atsteen/PrimeBox/README.md

# PrimeBox
Repository for PrimeBox Certified Horticulture Solutions
