atsteen/PrimeBox/Software Projects/PX Series Controller/Software Specifications/PX4/PX4_DisplayMocks.xlsx

Sheet: Sheet2
UC#FR_P_0100
UC#FR_P_0100
 | 1 | 2 | 3 | 4 | 5 | 6 | 7 | 8 | 9 | 10 | 11 | 12 | 13 | 14 | 15 | 16 | 17 | 18 | 19 | 20 | 21
1 | á | 6 | 8 | ° | Û | 5 | 0 | % |  |  |  | ϻ | O | K |  | 0 | 0 | : | 0 | 0 | /n
2 | < |  | E | V | E | N | T |  | T | E | X | T |  | > |  | 0 | 0 | : | 0 | 0 | /n
3 | < |  | E | V | E | N | T |  | T | E | X | T |  | > |  | 0 | 0 | : | 0 | 0 | /n
4 | < |  | E | V | E | N | T |  | T | E | X | T |  | > |  | 0 | 0 | : | 0 | 0 | /n
 | 1 | 2 | 3 | 4 | 5 | 6 | 7 | 8 | 9 | 10 | 11 | 12 | 13 | 14 | 15 | 16 | 17 | 18 | 19 | 20
UC#FR_P_0110
UC#FR_P_0110
 | 1 | 2 | 3 | 4 | 5 | 6 | 7 | 8 | 9 | 10 | 11 | 12 | 13 | 14 | 15 | 16 | 17 | 18 | 19 | 20 | 21
1 |  |  |  |  |  |  |  |  |  |  |  |  |  |  |  |  |  |  |  |  | /n
2 |  |  | ! |  | S | Y | S | T | E | M |  | E | R | R | O | R |  | ! |  |  | /n
3 |  |  | N | O |  | T | I | M | E |  | P | R | O | V | I | D | E | R |  |  | /n
4 |  |  |  |  |  |  |  |  |  |  |  |  |  |  |  |  |  |  |  |  | /n
 | 1 | 2 | 3 | 4 | 5 | 6 | 7 | 8 | 9 | 10 | 11 | 12 | 13 | 14 | 15 | 16 | 17 | 18 | 19 | 20
UC#FR_P_0120
UC#FR_P_0120b |  |  |  |  |  |  |  |  |  |  |  |  |  |  |  |  |  |  |  |  |  | UC#FRP_0120c
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
