atsteen/PrimeBox/Hardware Projects/PX4 Controller (BOM+Models)/PX4_FrontFace.step

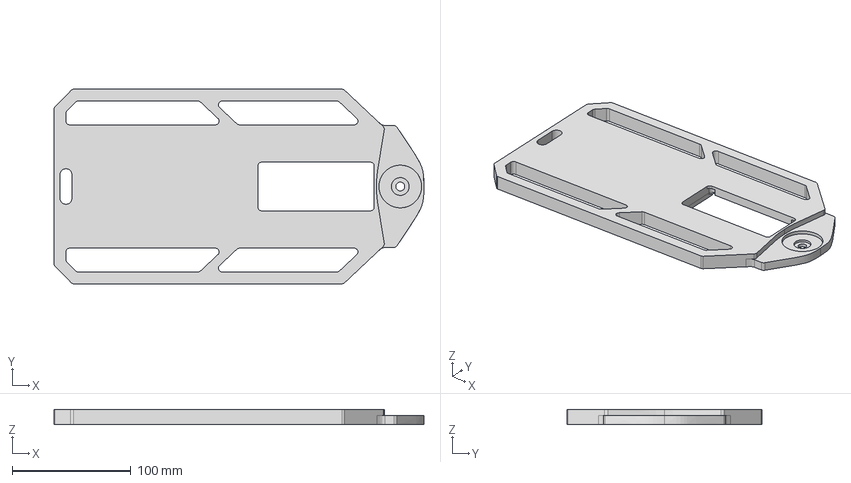
[picture p3: CAD file, 2018-09-19]
Hardware Projects/PX4 Controller (BOM+Models)/PX4_FrontFace.step
312.0 x 164.1 x 12.7 mm
