atsteen/PrimeBox/Hardware Projects/PX4 Controller (BOM+Models)/PX4_RearEnclosure.step

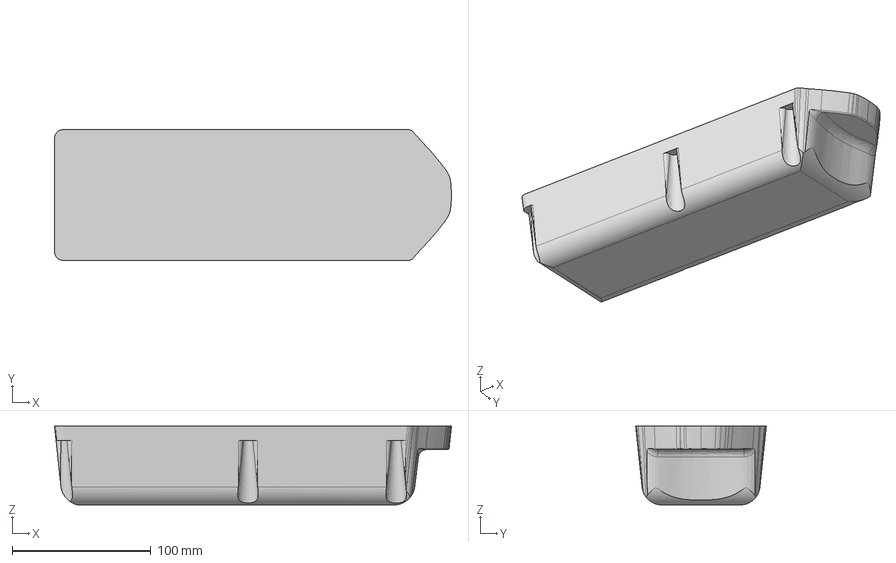
[picture p4: CAD file, 2018-09-19]
Hardware Projects/PX4 Controller (BOM+Models)/PX4_RearEnclosure.step
286.6 x 94.4 x 57.0 mm
