atsteen/PrimeBox/Software Projects/PX Series Controller/CodeBase/Platform/include/TaskHandler/Viewstate_TaskHandlers/PX4_ScheduledTasksConfig_SetView_TaskHandler.h

/*
* This file is part of the PX series horticulture appliance codebase (https://github.com/atsteen/PrimeBox).
* Copyright (c) 2017-2018 Sound Venture Group LLC.
*
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
* You should have received a copy of the GNU General Public License
* along with this program. If not, see <http://www.gnu.org/licenses/>.
*/

#pragma once

#include "..\..\SharedStructure\SharedInterface\ITaskHandler.h"
#include "..\..\SharedStructure\SharedInterface\IModelViewstateData.h"
#include "..\..\SharedStructure\SharedInterface\IModelTaskData.h"
#include "..\..\SharedStructure\SharedInterface\IViewstateMapGenerator.h"
#include "..\..\SharedStructure\SharedInterface\IPowerRelayArray.h"
#include "..\..\SharedStructure\TaskItemPool.h"

class PX4_ScheduledTasksConfig_SetView_TaskHandler : public ITaskHandler
{
public:
	PX4_ScheduledTasksConfig_SetView_TaskHandler(IModelViewstateData * viewstateData, IModelTaskData * taskData, IViewstateMapGenerator * mapGenerator, IPowerRelayArray * relayArray, INavigationTones * navTonePlayer)
		: _viewstateData(viewstateData), _taskData(taskData), _mapGenerator(mapGenerator), _relayArray(relayArray), _navTonePlayer(navTonePlayer){};
	~PX4_ScheduledTasksConfig_SetView_TaskHandler() {};

	static bool HandleIt() {};

	// Inherited via ITaskHandler
	virtual bool HandleTask(TaskItem *) override;
	virtual const bool FlagStateChange() override;

protected:
	virtual bool _CanHandleTask(TaskItem *) override;

private:
	IModelViewstateData * _viewstateData;
	IModelTaskData * _taskData;
	IViewstateMapGenerator * _mapGenerator;
	IPowerRelayArray * _relayArray;
	INavigationTones * _navTonePlayer;
};

inline bool PX4_ScheduledTasksConfig_SetView_TaskHandler::HandleTask(TaskItem * _taskItem)
{
	if (!_CanHandleTask(_taskItem)) { return false; }

	const int currentSelectedIndex = _viewstateData->GetViewstateSelectableElementIndex();
	const SelectableViewstateElementAlias currentlySelectedElement = _viewstateData->GetNavigationMap()->CurrentSelection()->selectedElement;
	int nextSelectedListIndex = currentSelectedIndex;
	SelectableViewstateElementAlias nextSelectedElement = SelectableViewstateElementAlias::SELECTABLE_ELEMENT_NOT_SET;
	const int scheduledTasksCount = SCHEDULED_TASK_DETAIL_COUNT - _taskData->GetFreeScheduledTaskDetailCount();

	switch (_taskItem->GetTaskAssociation())
	{
	case TaskAlias::TASKALIAS_NAVIGATION_MENU_MOVE_RIGHT:
		if (currentlySelectedElement == SelectableViewstateElementAlias::SELECTABLE_BACK_ELEMENT && currentSelectedIndex == 0)
		{
			nextSelectedElement = SelectableViewstateElementAlias::SELECTABLE_ELEMENT_DYNAMIC;
			nextSelectedListIndex = 0;
		}
		else if (currentSelectedIndex < scheduledTasksCount - 1) { ++nextSelectedListIndex; }
		_viewstateData->ForceModelUpdateNotify();
		_navTonePlayer->playNavTone();
		break;

	case TaskAlias::TASKALIAS_NAVIGATION_MENU_MOVE_LEFT:
		if (currentlySelectedElement == SelectableViewstateElementAlias::SELECTABLE_ELEMENT_DYNAMIC && currentSelectedIndex == 0)
		{
			nextSelectedElement = SelectableViewstateElementAlias::SELECTABLE_BACK_ELEMENT;
		}
		else if (currentlySelectedElement != SelectableViewstateElementAlias::SELECTABLE_BACK_ELEMENT && currentSelectedIndex > 0)
		{
			--nextSelectedListIndex;
		}
		_viewstateData->ForceModelUpdateNotify();
		_navTonePlayer->playNavTone();
		break;

	case TaskAlias::TASKALIAS_NAVIGATION_MENU_SELECT:
		ScheduledTaskDetail * selectedTaskDetail = _taskData->GetScheduledTaskDetailByIndex(currentSelectedIndex);
		bool taskEnabledStatus = *selectedTaskDetail->GetScheduledTaskEnabledState();
		taskEnabledStatus = !taskEnabledStatus;
		selectedTaskDetail->SetScheduledTaskEnabledState(&taskEnabledStatus);
		_navTonePlayer->playSelectTone();
		break;
	}

	ISelectableNavigationMap * const map = _viewstateData->GetNavigationMap();
	if (nextSelectedElement != SelectableViewstateElementAlias::SELECTABLE_ELEMENT_NOT_SET) { map->SetSelection(nextSelectedElement); }
	_viewstateData->SetViewstateSelectableElementIndex(nextSelectedListIndex);
	_viewstateData->SetNavigationMap(map); //SetNavigationMap call required to trigger viewstate refresh callback

	return true;
}

inline bool PX4_ScheduledTasksConfig_SetView_TaskHandler::_CanHandleTask(TaskItem * _taskItem)
{
	if (_viewstateData->GetNavigationMap()->ViewstateAssociation() != ViewstateAlias::VIEWSTATEALIAS_SCHEDULED_TASK_SET_EXISTING_VIEW) { return false; }

	// This handler only handles menu select or menu navigation tasks
	const TaskAlias currentTaskAssociation = _taskItem->GetTaskAssociation();
	if (currentTaskAssociation != TaskAlias::TASKALIAS_NAVIGATION_MENU_SELECT &&
		currentTaskAssociation != TaskAlias::TASKALIAS_NAVIGATION_MENU_MOVE_LEFT &&
		currentTaskAssociation != TaskAlias::TASKALIAS_NAVIGATION_MENU_MOVE_RIGHT)
	{
		return false;
	}

	return true;
}

inline const bool PX4_ScheduledTasksConfig_SetView_TaskHandler::FlagStateChange()
{
	return true;
}
