atsteen/PrimeBox/Software Projects/PX Series Controller/CodeBase/Platform/include/TaskHandler/StateRefresh_TaskHandler/PX4_StateRefresh_FansCirculation.h

/*
* This file is part of the PX series horticulture appliance codebase (https://github.com/atsteen/PrimeBox).
* Copyright (c) 2017-2018 Sound Venture Group LLC.
*
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
* You should have received a copy of the GNU General Public License
* along with this program. If not, see <http://www.gnu.org/licenses/>.
*/

#pragma once

#include "..\..\..\..\Configurations\PX4_Config.h"
#include "..\..\SharedStructure\SharedInterface\ITaskHandler.h"
#include "..\..\SharedStructure\SharedInterface\IModelEnvAirData.h"
#include "..\..\SharedStructure\SharedInterface\IModelSystemData.h"
#include "..\..\SharedStructure\SharedInterface\IModelEnvLightData.h"
#include "..\..\SharedStructure\SharedInterface\IRtcLogger.h"
#include "..\..\SharedStructure\SharedInterface\IPowerRelayArray.h"

class PX4_StateRefresh_FansCirculation : public ITaskHandler
{
public:
	PX4_StateRefresh_FansCirculation(IModelSystemData * systemData, IModelEnvAirData * environmentData, IModelEnvLightData * lightData, IRtcLogger * rtcLogger, IPowerRelayArray * powerRelayArray)
		: _systemData(systemData), _environmentData(environmentData), _lightData(lightData), _rtcLogger(rtcLogger), _powerRelayArray(powerRelayArray) {};

	~PX4_StateRefresh_FansCirculation() {};

	// Inherited via ITaskHandler
	virtual bool HandleTask(TaskItem *) override;
	virtual const bool FlagStateChange() override;

protected:
	virtual bool _CanHandleTask(TaskItem *) override;

private:
	IModelSystemData * _systemData;
	IModelEnvAirData * _environmentData;
	IModelEnvLightData * _lightData;
	IRtcLogger * _rtcLogger;
	IPowerRelayArray * _powerRelayArray;
};

inline bool PX4_StateRefresh_FansCirculation::HandleTask(TaskItem * _taskItem)
{
	if (!_CanHandleTask(_taskItem)) { return false; }

	bool alarmActive = _environmentData->GetAlarmState(EnvAirDataAlarmTypes::TEMP_OVER_THRESH) || _environmentData->GetAlarmState(EnvAirDataAlarmTypes::HUMIDITY_OVER_THRESH);

	if (alarmActive) {
		_powerRelayArray->EnableAllTypesInGroup(ComponentTypeAssociation::FAN_CIRCULATION, ComponentGroupAssociation::GROUP_A);
		return true;
	}
	else if (!*_environmentData->GetCirculationFanCycleDefaultState()) {
		// todo... no restore capability requires GROUP_A to function as alarm event items only, no way to restore non-default state
		_powerRelayArray->DisableAllTypesInGroup(ComponentTypeAssociation::FAN_CIRCULATION, ComponentGroupAssociation::GROUP_A);
		return true;
	}

	TimeSignature const * timeNow = &_rtcLogger->CurrentTime();
	// todo... convert currentDutyCycleDepthMins to seconds as fractions of minutes are rounded out
	int currentDutyCycleDepthMins = (timeNow->secondsInDay() / 60) % *_environmentData->GetCirculationFanDutyCycleDuration();
	int activeDutyCycleDepthMins = 0;

	if (timeNow->secondsInDay() > _lightData->GetDefaultSunriseTime()->secondsInDay() && timeNow->secondsInDay() < _lightData->GetDefaultSunsetTime()->secondsInDay())
	{
		activeDutyCycleDepthMins = (*_environmentData->GetCirculationFanDutyCycleDuration() * *_environmentData->GetCirculationFanDutyCycleDay()) / 100;
	}
	else // use night duty cycle
	{
		activeDutyCycleDepthMins = (*_environmentData->GetCirculationFanDutyCycleDuration() * *_environmentData->GetCirculationFanDutyCycleNight()) / 100;
	}

	if (currentDutyCycleDepthMins < activeDutyCycleDepthMins)
	{
		_powerRelayArray->EnableAllTypesInGroup(ComponentTypeAssociation::FAN_CIRCULATION, ComponentGroupAssociation::GROUP_A);
	}
	else { _powerRelayArray->DisableAllTypesInGroup(ComponentTypeAssociation::FAN_CIRCULATION, ComponentGroupAssociation::GROUP_A); }

	return true;
}

inline bool PX4_StateRefresh_FansCirculation::_CanHandleTask(TaskItem * _taskItem)
{
	if (_taskItem->GetTaskAssociation() == TaskAlias::TASKALIAS_REFRESH_STATE_CIRCULATION_FANS) { return true; }
	return false;
}

inline const bool PX4_StateRefresh_FansCirculation::FlagStateChange()
{
	return true;
}
