atsteen/PrimeBox/(commit log)

2017-08-28 Software Specifications (intial commit)
    The initial commit of the PX4 software specification including functional design specification and display mock content
    [PX4_DisplayMocks.xlsx]
2018-08-28 Initial major version commit. PXN platform V1.4 This commit includes almost all major updates to the 1.3x platform revisions. This commit does not include bridged implementations for Arduino compatib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
2018-08-28 Retying maor version commit (VS2017 update)
    Initial major version commit. PXN platform V1.4
    This commit includes almost all major updates to the 1.3x platform revisions.
    This commit does not include bridged implementations for Arduino compatible component modules (coming in later revisions)
    This commit includes all binaries necessary to run the full PX4 platform experience as an emulated instance on a Win32 host (win32 component implementations)
    [PX4_DisplayMocks.xlsx, PersistentDataValues.csv]
2018-08-31 Adding scheduled task delete task handlers Adding task hadlers to task factory Updating viewstate map generator with selectable map element Fixing viewstate selection bug in ViewstateGroup manager Up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
    [8_31.csv, PersistentDataValues.csv]
2018-08-31 Updating GitIgnore
    Updating the ignore file to avoid uploading logs and persistent data archive files for the emulated NvMemoryManager.
    [8_31.csv, PersistentDataValues.csv]
2018-09-06 Adding updated Atmel project
    The Atmel project added in this commit was imported from a template arduino sketch. Creating an Arduino project in atmel studio automatically includes and configures toolchain and device options necessary to program and hardware debug ATMega Microprocessors.
2018-09-09 Updating platform objects to fix null ref check bugs
    Compiling in Win32 inits pointers to null by default. GNU++ does not, this results in runtime crashes. Solution war to force init to null ref at declaration.
    ViewstateStringGenerator uses a temp char[] to store strings retrieved from NV memory. This array length was statically fixed to 21 chars and several new NV strings were longer then this. Result was overrun, fix was enlarging temp char[] size in ViewstateStringGenerator .
    [ComponentPackage_PowerRelayArray.h]
2018-09-10 Continuation of null ref fixes
    Additional improperly initialized pointers were corrected in datamodels. This issue was only observed in Atmel deployments (gnu++ compiler)
    Kept serial startup command in the bootstrap sketch.
    [DataModel_Environment_PX4.h, DataModel_System_PX4.h, DataModel_Viewstate_PX4.h]
2018-09-10 Updated refined component abstraction for power relay to enable state restore from persistent data
    When recovering from power loss, the power relay circuits would restore datamodels correctly but would not actually invoke concrete implementation state change. This commit resolves that.
    [ComponentModule_PowerRelay_Standard.cpp]
2018-09-19 Adding CAD models, PCB design files, and BOM list for PX4 project
    [PX4_FrontFace.step, PX4_RearEnclosure.step]
2018-09-25 Updating state event handler active duty cycle calculation
    Active duty cycle timespans were not being calculated correctly. Updated active duty cycle claculations in state event handlers as well as added escape logic for default light schedule when setting is disabled in the data model.
    [PX4_StateRefresh_FansCirculation.h, PX4_StateRefresh_FansExhaust.h, PX4_StateRefresh_Lights.h]
2018-09-25 Updated encoder implementation for AVR platform
    The encoder switch would double count switch selects when large current draws occured as a result. The PCB (v1.32) has a design flaw whereby the hardware debounce circuit is incorrectly designed resulting in partical hardware debouncing of the encoder switch. This update addressed that by activating the (underpowered) internal pullups on the ATMEGA2560 as well as adding a debounce delay/check in software.
2018-12-09 Adding status logging support for temperature and humidity
    The standard logging routines were not logging air temperature data. Added string generator elements to support air sensor message logging to local storage (SD on AVR)
2019-01-07 Update datamodels and state processing to handle alarm state (temp/humidity)
    Previously, there were no handlers to manage state changes due to alarm invocation. This commit adds structures and logic required to asynchronously flag and act against alarm conditions.
    - Task handlers were added explicitly for over_temp and over_humidity states
    - Pre-proc decs were added to assign alarm scan refresh intervals and recovery buffer values
    - data model and DM interfaces updated to maintain alarm state
    - Bug fix in eventlog_item_collection (null exception due to improper structure reuse)
    [DataModel_Environment_PX4.h, PX4_Config.h, PX4_StateRefresh_Alarms.h]
