atsteen/PrimeBox/(notices)

Notices in the files:
Software Projects/PX Series Controller/CodeBase/Platform/include/DataModel/DataModel_Task_PX4.h:
This program is free software: you can redistribute it and/or modify
it under the terms of the GNU General Public License as published by
the Free Software Foundation, version 3.
